tk20dk/garfield/kicad/garfield.pcb.png

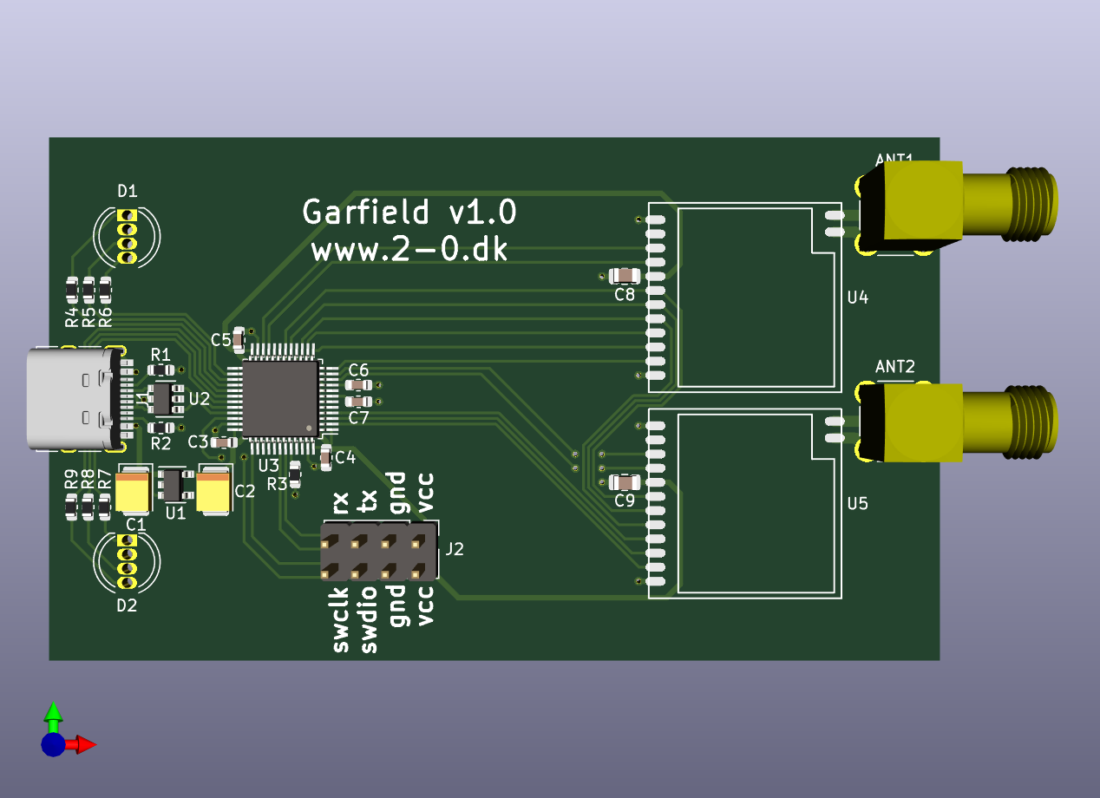
kicad/garfield.pcb.png
