tk20dk/garfield/stm32/Core/Inc/main.h

#define SDN_RADIO868_Pin GPIO_PIN_13
#define SDN_RADIO868_GPIO_Port GPIOC
#define IRQ_RADIO868_Pin GPIO_PIN_14
#define IRQ_RADIO868_GPIO_Port GPIOC
#define IRQ_RADIO868_EXTI_IRQn EXTI4_15_IRQn
#define CS_RADIO868_Pin GPIO_PIN_15
#define CS_RADIO868_GPIO_Port GPIOC
#define GPIO1_RADIO868_Pin GPIO_PIN_0
#define GPIO1_RADIO868_GPIO_Port GPIOA
#define GPIO0_RADIO868_Pin GPIO_PIN_1
#define GPIO0_RADIO868_GPIO_Port GPIOA
#define SDN_RADIO433_Pin GPIO_PIN_2
#define SDN_RADIO433_GPIO_Port GPIOA
#define IRQ_RADIO433_Pin GPIO_PIN_3
#define IRQ_RADIO433_GPIO_Port GPIOA
#define IRQ_RADIO433_EXTI_IRQn EXTI2_3_IRQn
#define CS_RADIO433_Pin GPIO_PIN_4
#define CS_RADIO433_GPIO_Port GPIOA
#define SPI__MISO_Pin GPIO_PIN_0
#define SPI__MISO_GPIO_Port GPIOB
#define GPIO1_RADIO433_Pin GPIO_PIN_10
#define GPIO1_RADIO433_GPIO_Port GPIOB
#define GPIO0_RADIO433_Pin GPIO_PIN_11
#define GPIO0_RADIO433_GPIO_Port GPIOB
#define LED1_BLUE_Pin GPIO_PIN_13
#define LED1_BLUE_GPIO_Port GPIOB
#define LED1_GREEN_Pin GPIO_PIN_14
#define LED1_GREEN_GPIO_Port GPIOB
#define LED1_RED_Pin GPIO_PIN_15
#define LED1_RED_GPIO_Port GPIOB
#define LED2_BLUE_Pin GPIO_PIN_8
#define LED2_BLUE_GPIO_Port GPIOA
#define LED2_GREEN_Pin GPIO_PIN_9
#define LED2_GREEN_GPIO_Port GPIOA
#define LED2_RED_Pin GPIO_PIN_10
#define LED2_RED_GPIO_Port GPIOA
#define UART_TX_Pin GPIO_PIN_6
#define UART_TX_GPIO_Port GPIOB
#define UART_RX_Pin GPIO_PIN_7
#define UART_RX_GPIO_Port GPIOB
