tk20dk/garfield/(notices)

Notices in the files:
stm32/Core/Inc/main.h:
© Copyright (c) 2020 STMicroelectronics.
All rights reserved.
This software component is licensed by ST under Ultimate Liberty license
(C) COPYRIGHT STMicroelectronics *****END OF FILE
